nsaspook/mphase/Microchip rainbow.jpg

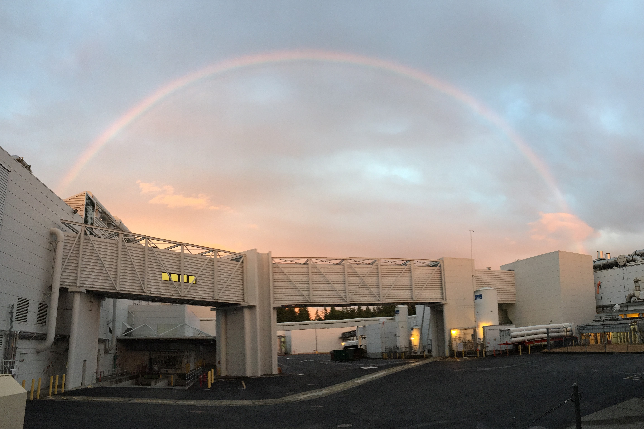
Microchip rainbow.jpg
