nsaspook/mphase/board/mphase.pdf

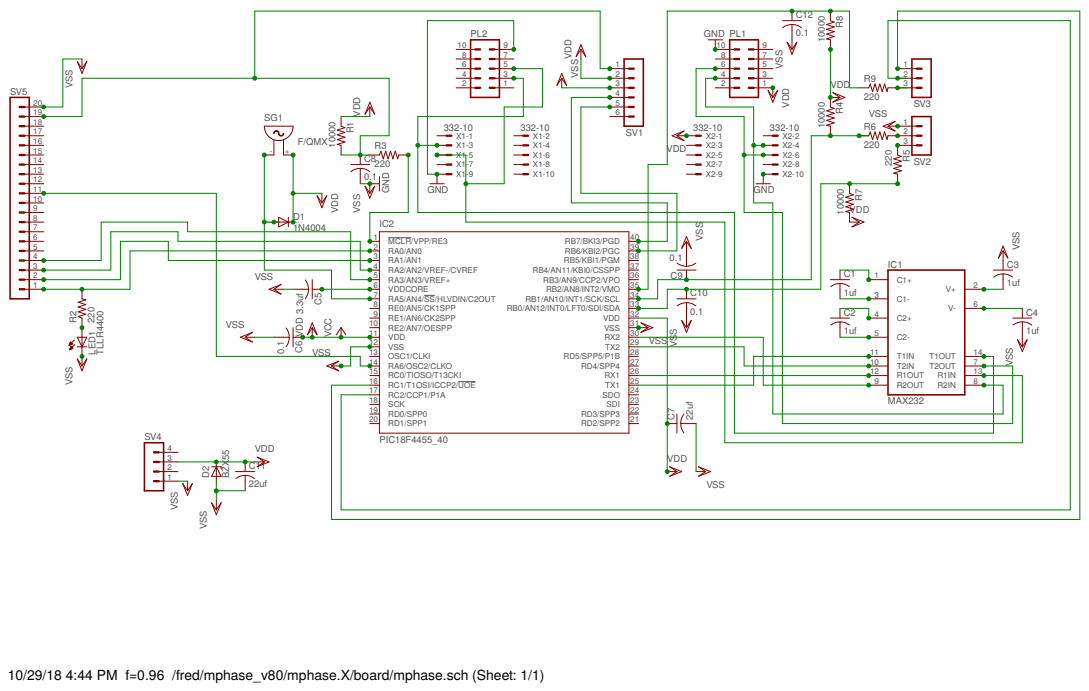
[picture p3: page 1]

10/29/18 4:44 PM f=0.96 /fred/mphase_v80/mphase.X/board/mphase.sch (Sheet: 1/1)
