nsaspook/mphase/board/mphase_board.pdf

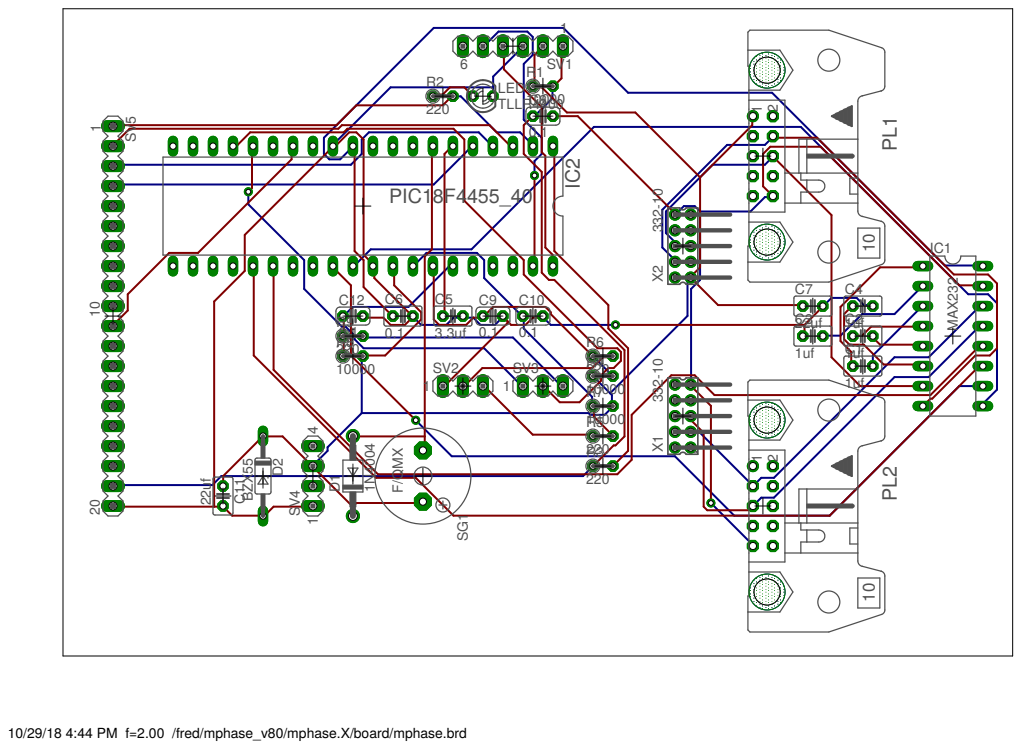
[picture p4: page 1]

10/29/18 4:44 PM f=2.00 /fred/mphase_v80/mphase.X/board/mphase.brd
