nsaspook/mphase/pigtail.pdf

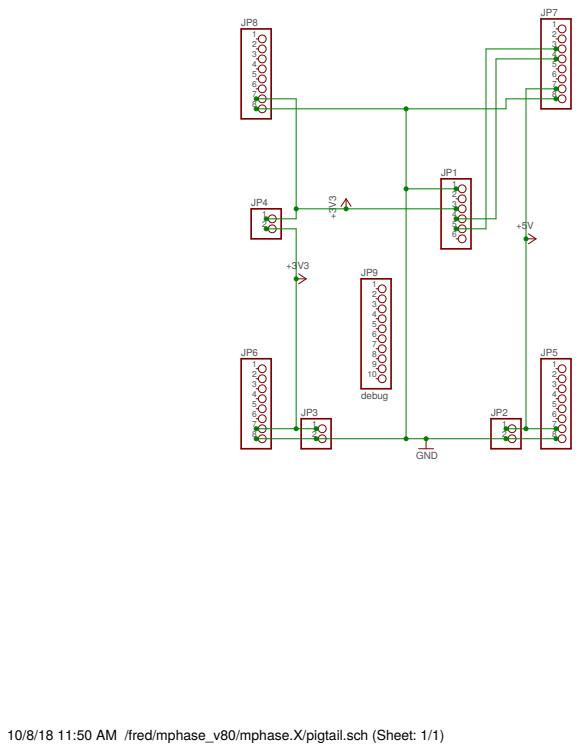
[picture p5: page 1]

10/8/18 11:50 AM /fred/mphase_v80/mphase.X/pigtail.sch (Sheet: 1/1)
