nsaspook/mphase/board/mphase.brd

## EAGLE design board/mphase.brd (2018-10-30)

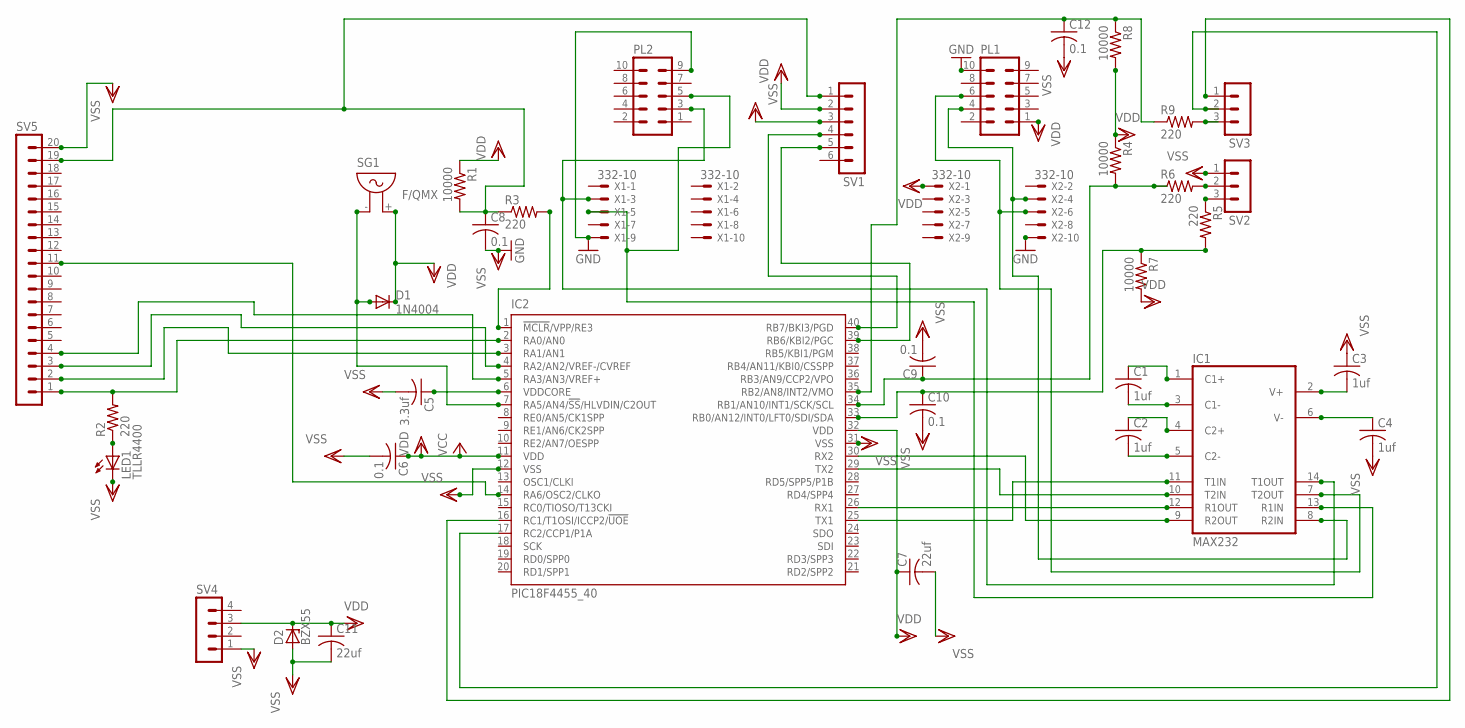
[picture p6: schematic mphase.sch]

Parts:
C1, C2, C3, C4: 1uf; C025-025X050
C5: 3.3uf; C025-025X050
C6: 0.1; C025-025X050
C7, C11: 22uf; C025-025X050
C8, C9, C10, C12: 0.1; C025-024X044
D1: 1N4004; DO41-10
D2: BZX55; DO35Z10
IC1: MAX232; DIL16
IC2: PIC18F4455_40; DIL40; MPN PIC18F45K80
LED1: TLLR4400; LED3MM
PL1, PL2: 10H
R1, R4, R7, R8: 10000; 0204V
R2, R3, R5, R6, R9: 220; 0204V
SG1: F/QMX
SV1: MA06-1
SV2, SV3: MA03-1
SV4: MA04-1
SV5: MA20-1
X1, X2: 332-10

Connections:
GND: C8.2, IC1.15 (GND), PL1.10, PL2.9, X1.9, X2.10
unnamed: C1.2, IC1.3 (C1-)
unnamed: C2.2, IC1.5 (C2-)
unnamed: C2.1, IC1.4 (C2+)
unnamed: C1.1, IC1.1 (C1+)
unnamed: C3.2, IC1.2 (V+)
unnamed: C4.1, IC1.6 (V-)
unnamed: D1.A, IC2.7 (RA5/AN4/!SS!/HLVDIN/C2OUT), SG1.- (1)
unnamed: C8.1, R1.2, R3.1, SV1.1, SV5.19
unnamed: C5.1, IC2.6 (VDDCORE)
unnamed: IC1.10 (T2IN), IC2.29 (TX2)
unnamed: IC1.11 (T1IN), IC2.25 (TX1)
unnamed: IC1.12 (R1OUT), IC2.26 (RX1)
unnamed: IC1.9 (R2OUT), IC2.30 (RX2)
unnamed: IC2.1 (!MCLR!/VPP/RE3), R3.2
unnamed: IC2.2 (RA0/AN0), R2.2, SV5.1
unnamed: IC1.7 (T2OUT), PL1.6, X2.6
unnamed: IC1.8 (R2IN), PL1.4, X2.4
unnamed: LED1.A, R2.1
unnamed: IC1.14 (T1OUT), PL2.3, X1.3
unnamed: IC1.13 (R1IN), PL2.5, X1.5
unnamed: C9.1, IC2.34 (RB1/AN10/INT1/SCK/SCL), R4.2, R6.1
unnamed: C10.1, IC2.33 (RB0/AN12/INT0/LFT0/SDI/SDA), R5.2, R7.1
unnamed: IC2.3 (RA1/AN1), SV5.2
unnamed: R6.2, SV2.2
unnamed: R5.1, SV2.3
unnamed: IC2.4 (RA2/AN2/VREF-/CVREF), SV5.3
unnamed: IC2.5 (RA3/AN3/VREF+), SV5.4
unnamed: C12.1, IC2.35 (RB2/AN8/INT2/VMO), R8.1, R9.1
unnamed: IC2.40 (RB7/BKI3/PGD), SV1.4
unnamed: IC2.14 (RA6/OSC2/CLKO), SV5.11
unnamed: R9.2, SV3.3
unnamed: IC2.39 (RB6/KBI2/PGC), SV1.5
unnamed: IC2.16 (RC1/T1OSI/ICCP2/!UOE), SV3.1
unnamed: IC2.17 (RC2/CCP1/P1A), SV3.2
VCC: C6.1, IC1.16 (VCC), IC2.11 (VDD)
VDD: C7.1, C11.1, D1.C, D2.C, IC2.32 (VDD), PL1.1, R1.1, R4.1, R7.2, R8.2, SG1.+ (2), SV1.2, SV4.3, X2.1
VSS: C3.1, C4.2, C5.2, C6.2, C7.2, C9.2, C10.2, C11.2, C12.2, D2.A, IC2.12 (VSS), IC2.31 (VSS), LED1.K (C), SV1.3, SV2.1, SV4.1, SV5.20

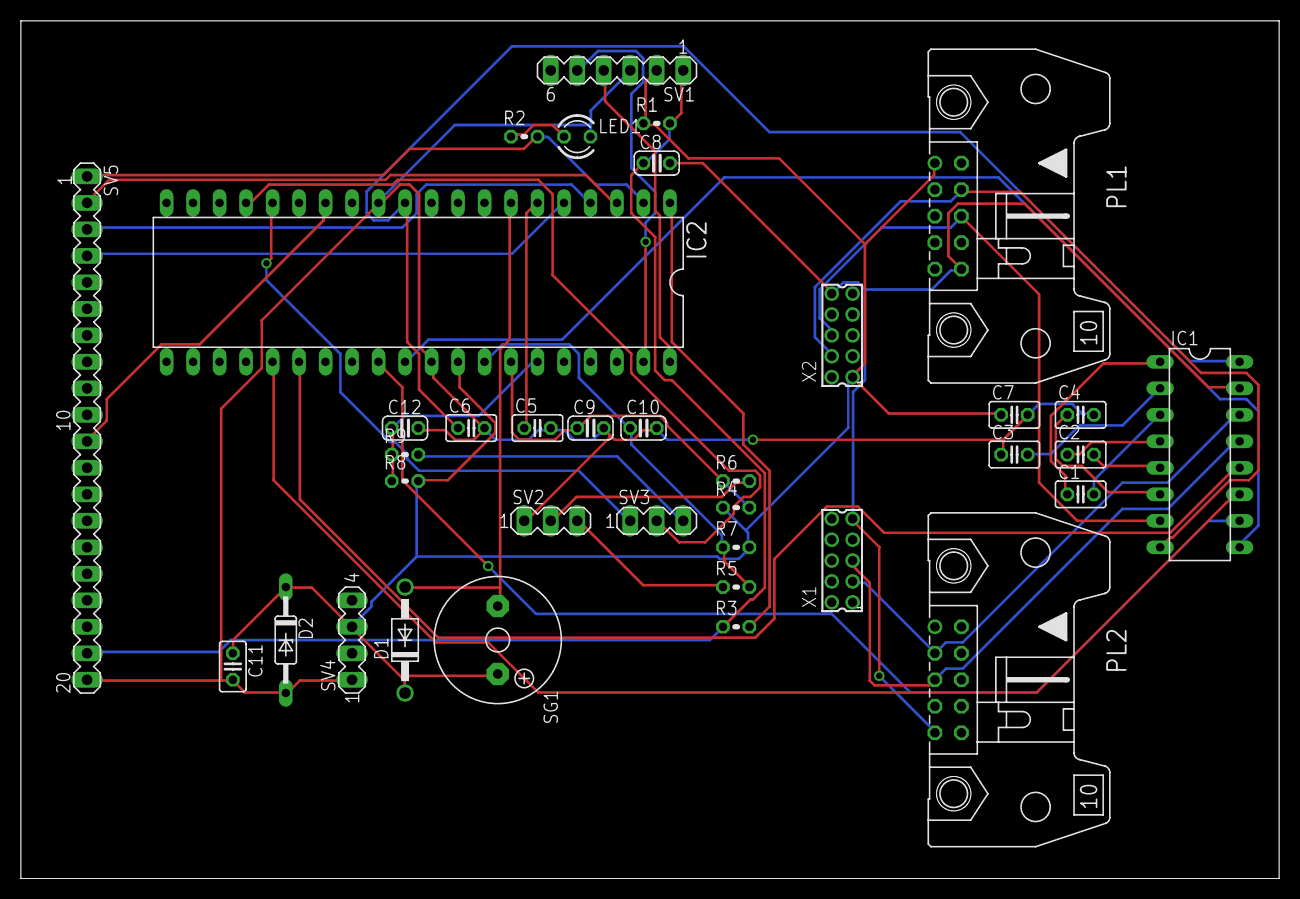
[picture p7: board mphase.brd from above]

Board: 2 copper layers, 120.6 x 82.2 mm, 36 parts (0 on the bottom side), 38 nets.
