nsaspook/mphase/pigtail.brd

## EAGLE design pigtail.brd (2018-10-08)

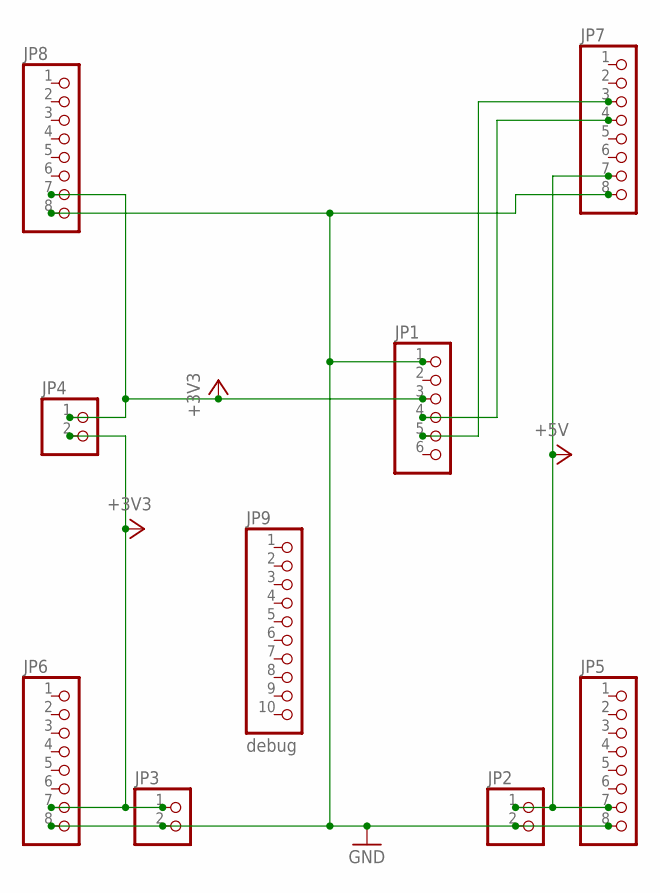
[picture p8: schematic pigtail.sch]

Parts:
JP1: PINHD-1X6; 1X06
JP2, JP3, JP4: PINHD-1X2; 1X02
JP5, JP6, JP7, JP8: PINHD-1X8; 1X08
JP9: debug; 1X10

Connections:
+3V3: JP1.3, JP3.1, JP4.1, JP4.2, JP6.7, JP8.7
+5V: JP2.1, JP5.7, JP7.7
GND: JP1.1, JP2.2, JP3.2, JP5.8, JP6.8, JP7.8, JP8.8
unnamed: JP1.4, JP7.4
unnamed: JP1.5, JP7.3

Board: 2 copper layers, 9 parts (0 on the bottom side), 5 nets, no tracks yet.
