nsaspook/mphase/pfb.h

/* 
 * File:   pfb.h
 * Author: root
 *
 * Created on October 23, 2018, 12:12 PM
 */

#ifndef PFB_H
#define	PFB_H

#ifdef	__cplusplus
extern "C" {
#endif

#include <xc.h>
#include <stdint.h>
#include <stdbool.h>
#include <stdio.h>
#include <string.h>
#include <math.h>
#include "config.h"

	uint16_t get_pfb(const char *);

#ifdef	__cplusplus
}
#endif

#endif	/* PFB_H */
